Kostecki/smart-usb-relay/hardware/Smart USB Relay.kicad_pcb

## KiCad design hardware/Smart USB Relay.kicad_pcb (2026-11-06)

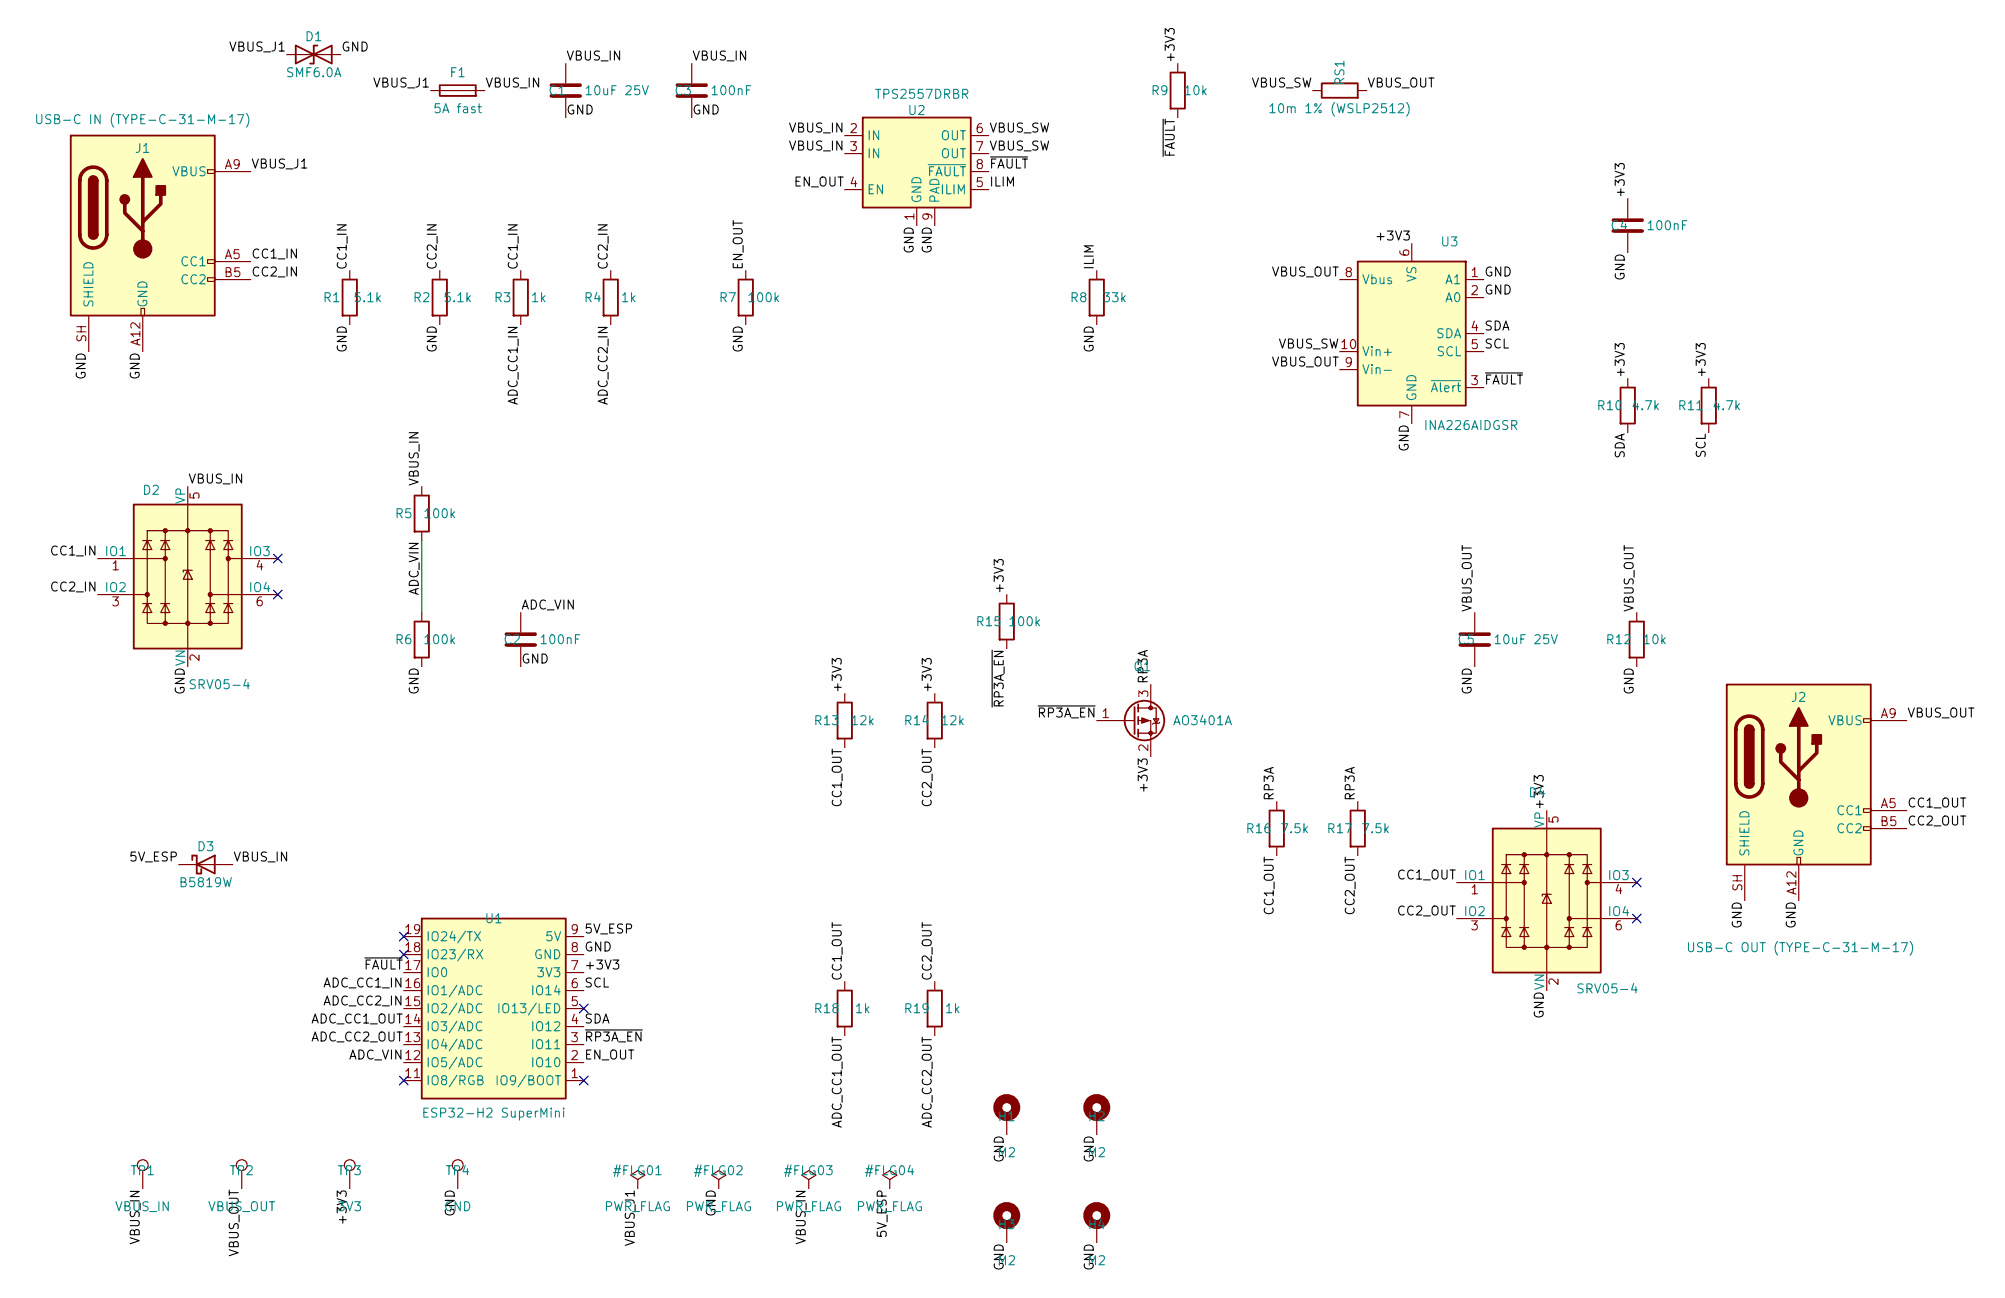
[picture p1: schematic Smart USB Relay.kicad_sch]

Parts:
C1, C5: 10uF 25V; C_0805_2012Metric; LCSC C15850
C2, C3, C4: 100nF; C_0603_1608Metric; LCSC C14663
D1: SMF6.0A; SOD-123FL_L2.7-W1.8-LS3.8-RD; LCSC C19077499
D2, D4: SRV05-4; SOT-23-6_L2.9-W1.6-P0.95-LS2.8-BR; LCSC C85364
D3: B5819W; SOD-123_L2.7-W1.6-LS3.7-RD-1; LCSC C8598
F1: 5A fast; F1206; LCSC C136351
H1, H2, H3, H4: M2; MountingHole_2.2mm_M2_Pad_Via
J1: USB-C IN (TYPE-C-31-M-17); USB_C_Receptacle_HRO_TYPE-C-31-M-17; LCSC C283540
J2: USB-C OUT (TYPE-C-31-M-17); USB_C_Receptacle_HRO_TYPE-C-31-M-17; LCSC C283540
Q1: AO3401A; SOT-23_L2.9-W1.3-P1.90-LS2.4-BR; LCSC C15127
R1, R2: 5.1k; R_0603_1608Metric; LCSC C23186
R3, R4, R18, R19: 1k; R_0603_1608Metric; LCSC C21190
R5, R6, R7, R15: 100k; R_0603_1608Metric; LCSC C25803
R8: 33k; R_0603_1608Metric; LCSC C4216
R9, R12: 10k; R_0603_1608Metric; LCSC C25804
R10, R11: 4.7k; R_0603_1608Metric; LCSC C23162
R13, R14: 12k; R_0603_1608Metric; LCSC C22790
R16, R17: 7.5k; R_0603_1608Metric; LCSC C23234
RS1: 10m 1% (WSLP2512); R2512; LCSC C241862
TP1: VBUS_IN; TestPoint_Pad_D1.5mm
TP2: VBUS_OUT; TestPoint_Pad_D1.5mm
TP3: 3V3; TestPoint_Pad_D1.5mm
TP4: GND; TestPoint_Pad_D1.5mm
U1: ESP32-H2 SuperMini; ESP32-H2_SuperMini_Header
U2: TPS2557DRBR; SON-8_L3.0-W3.0-P0.65-LS3.0-BL-EP; LCSC C130056
U3: INA226AIDGSR; MSOP-10_L3.0-W3.0-P0.50-LS5.0-BL; LCSC C49851

Connections:
/5V_ESP: D3.1 (K), U1.9 (5V)
/+3V3: C4.1, D4.5 (VP), Q1.2 (S), R9.1, R10.1, R11.1, R13.1, R14.1, R15.1, TP3.1, U1.7 (3V3), U3.6 (VS)
/ADC_CC1_IN: R3.2, U1.16 (IO1/ADC)
/ADC_CC1_OUT: R18.2, U1.14 (IO3/ADC)
/ADC_CC2_IN: R4.2, U1.15 (IO2/ADC)
/ADC_CC2_OUT: R19.2, U1.13 (IO4/ADC)
/ADC_VIN: C2.1, R5.2, R6.1, U1.12 (IO5/ADC)
/CC1_IN: D2.1 (IO1), J1.A5 (CC1), R1.1, R3.1
/CC1_OUT: D4.1 (IO1), J2.A5 (CC1), R13.2, R16.2, R18.1
/CC2_IN: D2.3 (IO2), J1.B5 (CC2), R2.1, R4.1
/CC2_OUT: D4.3 (IO2), J2.B5 (CC2), R14.2, R17.2, R19.1
/EN_OUT: R7.1, U1.2 (IO10), U2.4 (EN)
/GND: C1.2, C2.2, C3.2, C4.2, C5.2, D1.2 (A2), D2.2 (VN), D4.2 (VN), H1.1, H2.1, H3.1, H4.1, J1.A12 (GND), J1.B12 (GND), J1.SH (SHIELD), J2.A12 (GND), J2.B12 (GND), J2.SH (SHIELD), R1.2, R2.2, R6.2, R7.2, R8.2, R12.2, TP4.1, U1.8 (GND), U2.1 (GND), U2.9 (PAD), U3.1 (A1), U3.2 (A0), U3.7 (GND)
/ILIM: R8.1, U2.5 (ILIM)
/RP3A: Q1.3 (D), R16.1, R17.1
/SCL: R11.2, U1.6 (IO14), U3.5 (SCL)
/SDA: R10.2, U1.4 (IO12), U3.4 (SDA)
/VBUS_IN: C1.1, C3.1, D2.5 (VP), D3.2 (A), F1.2, R5.1, TP1.1, U2.2 (IN), U2.3 (IN)
/VBUS_J1: D1.1 (A1), F1.1, J1.A9 (VBUS), J1.B9 (VBUS)
/VBUS_OUT: C5.1, J2.A9 (VBUS), J2.B9 (VBUS), R12.1, RS1.2, TP2.1, U3.8 (Vbus), U3.9 (Vin-)
/VBUS_SW: RS1.1, U2.6 (OUT), U2.7 (OUT), U3.10 (Vin+)
/~FAULT: R9.2, U1.17 (IO0), U2.8 (~FAULT), U3.3 (~Alert)
/~RP3A_EN: Q1.1 (G), R15.2, U1.3 (IO11)

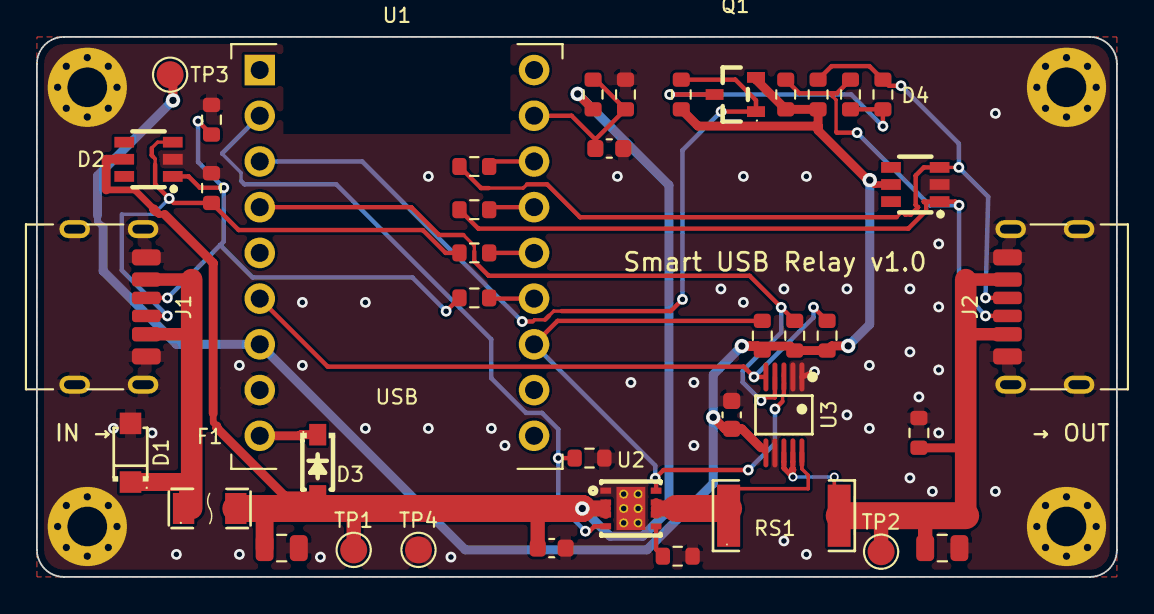
[picture p2: board Smart USB Relay.kicad_pcb from above]

Board: 2 copper layers, 60.0 x 30.0 mm, 44 parts (0 on the bottom side), 23 nets.
