Kostecki/smart-usb-relay/(commit log)

2026-10-30 Initial hardware design: schematic, PCB, libraries and fab script
    KiCad 10 project for the Smart USB Relay (ESP32-H2 SuperMini, TPS2557,
    INA226, USB-C in/out), the agreed spec, and scripts/fab.sh, which runs
    ERC/DRC with schematic parity and builds the JLCPCB Gerbers, drill, BOM
    and CPL. CI runs the same script in kicad/kicad:10.0.7.
    [Smart USB Relay.kicad_pcb, Smart USB Relay.kicad_sch]
2026-10-30 Re-save schematic and project in KiCad 10.0.7
    KiCad upgraded the schematic file format and filled in the revision.
    Netlist, components and BOM are unchanged.
    [Smart USB Relay.kicad_sch]
2026-10-30 Add ESPHome firmware for ESP32-H2 over Thread
    Output switch with USB-C attach detection on CC_OUT, 3 A advertisement
    only when the charger offers it, latched overcurrent (hardware FAULT
    or software limit), power-on behaviour, and INA226 voltage, current,
    power and energy. secrets.yaml stays git-ignored; see the example.
2026-10-30 Document getting the Thread TLV with an Apple border router
    HA only shows the dataset TLV for its own OTBR. With an Apple TV, send
    the credentials from the iPhone companion app, then read the TLV with
    thread/get_dataset_tlv in the browser console. Verified on the real setup.
2026-10-30 Firmware: set the device name directly instead of via substitutions
    The substitutions were each used once; with the full config kept in the
    ESPHome dashboard, they only added indirection.
2026-10-30 Firmware: describe the SuperMini by chip and flash size, not a DevKit board
    The esp32-h2-devkitm-1 board was only borrowed for its 4 MB flash
    setting. Same partitions and build size.
2026-10-30 fab: shift USB-C placements to JLC's footprint origin
    KiCad's HRO TYPE-C-31-M-17 footprint has its origin 1.25 mm from the
    LCSC/EasyEDA one that JLC places, so both sockets landed off their
    holes and pads in the assembly preview. Apply the offset in the
    footprint's own axes when writing the CPL; verified in JLC's preview.
2026-10-30 PCB: SuperMini 'USB' mark under the module, vias out of pads
    - The orientation mark now reads just 'USB' and sits 4 mm inside the
    module outline, hidden once the SuperMini is mounted.
    - Move vias that touched pads: TP4 (probe pad), C1, R12 and J2's CC
    pads (solder wicking during reflow); drop the redundant one on U3
    pin 1, which already has its own GND via.
    [Smart USB Relay.kicad_pcb]
2026-10-31 Use JLC Preferred SRV05-4 (C85364) for D2/D4
    Same SOT-23-6 footprint and pinout as C13612, but a Preferred part, so
    no extended-part setup fee (saves ~$3 per order).
    [Smart USB Relay.kicad_pcb, Smart USB Relay.kicad_sch]
2026-11-06 Add LCSC 3D model to the USB-C footprint
    [Smart USB Relay.kicad_pcb, Smart USB Relay.kicad_sch]
